diegopandolfa/ZEBRA/REDISEÑO/carrito_ZEBRA_digikey.pdf

carrito_ZEBRA_digikey
Index | Quantity | Part Number | Description
1 | 12493-1533-ND | | CAP ALUM 2200UF 20% 16V RADIAL
2 | 12493-1527-ND | | CAP ALUM 1000UF 20% 16V RADIAL
3 | 100 493-14722-1-ND | | CAP ALUM 100UF 20% 16V THRU HOLE
4 | 168 493-9414-1-ND | | CAP ALUM 220UF 20% 16V SMD
5 | 25493-9413-1-ND | | CAP ALUM 22UF 20% 16V SMD
6 | 12445-9911-1-ND | | CAP CER 1UF 16V X7R 0805
7 | 12493-9365-1-ND | | CAP ALUM 10UF 20% 16V SMD
8 | 25 A32562-ND | | CONN HEADER RTANG 8POS PCB TIN
9 | 25 A33904-ND | | CONN HEADER VERT 8POS PCB TIN
10 | 50 A28417-ND | | CONN RECPT 8POS .1" POL UNLOAD
11 | 100 1276-5298-1-ND | | RES SMD 3.3K OHM 1% 1/8W 0805
12 | 120 P1.0KDACT-ND | | RES SMD 1K OHM 0.1% 1/8W 0805
13 | 100 SS34FSCT-ND | | DIODE SCHOTTKY 40V 3A SMC
14 | 12296-37820-ND | | SENSOR TEMP ANLG VOLT TO-92-3
15 | 12497-2615-5-ND | | TRANS NPN 100V 3A TO-220
16 | 100 296-35399-1-ND | | IC REG BUCK ADJ 3A TO263-5
17 | 12160-1853-ND | | LED RED DIFF 5MM ROUND T/H
18 | 12 A9CCG-1603F-ND | | FLEX CABLE - AFG16G/AF16/AFG16G
19 | 24 A33890-ND | | CONN HEADER RTANG 16POS PCB TIN
20 | 25 A98248-ND | | TERM BLOCK HDR 2POS 90DEG 5MM
21 | 25 A98241-ND | | TERM BLOCK PLUG 2POS STR 5MM
22 | 36 A98249-ND | | TERM BLOCK HDR 3POS 90DEG 5MM
23 | 36 A113286-ND | | TERM BLOCK PLUG 3POS STR 5MM
24 | 132 P330CCT-ND | | RES SMD 330 OHM 1% 1/8W 0805
25 | 12497-1228-1-ND | | IC REG LINEAR 3.3V 1A SOT223
26 | 12 MMBT3904LT3GOSCT-ND | | TRANS NPN 40V 0.2A SOT23
27 | 108 TLP2745(TPECT-ND | | OPTOISO 5KV PUSH PULL SO6L
28 | 12768-1007-1-ND | | IC USB FS SERIAL UART 28-SSOP
29 | 100 CKN10684CT-ND | | SWITCH TACTILE SPST-NO 50MA 32V
30 | 300 1276-1096-1-ND | | CAP CER 10UF 16V X5R 0805
31 | 84 SRR1210-470MCT-ND | | FIXED IND 47UH 3.8A 72 MOHM SMD
32 | 121568-1464-ND | | TEENSY 3.5 (HEADERS)
33 | 12296-46127-1-ND | | ANALOG TEMPERATURE SENSOR
34 | 4 602-1558-ND | | RF TXRX MODULE 802.15.4 RP-SMA
35 | 4 553-1309-ND | | ANTENNA 2.4GHZ R-SMA BLACK 3"
36 | 276 1276-1099-1-ND | | CAP CER 0.1UF 25V X7R 0805
37 | 121582-1117-ND | | MEMORY CARD MICROSD 256MB SLC

Customer Reference | Available Quantity
CAP 2200 UF 16V | 12
CAP 1000UF 16V | 12
CAP 100UF 16V | 100
CAP 220UF 16V | 168
CAP 22UF 16V | 25
CAP 1UF 16V | 12
CAP 10UF 16V | 12
SOCKET HACIA PANELES (THRWHOLE RIGHT ANGLE) | 25
SOCKET PARA PANELES (THROWHOLE) | 25
CONECTORES PANELES | 50
RESISTENCIA PARA EL BUCK | 100
RESISTENCIA PARA EL BUCK | 120
DIODO PARA EL BUCK | 100
SENSOR DE TEMPERATURA | 12
PARA LA LUMINARIA | 12
LM2596 STEP DOWN BUCK | 100
LED INDIADOR DE LA PLACA DE POTENCIA | 12
CABLE FLEX DE AMBAS PLACAS | 0
CONECTOR PARA EL FLEX DE AMBAS PLACAS | 24
CONECTOR PCB PARA BRAZO Y ALIMENTACION | 25
CONECTOR CABLES BRAZO Y ALIMENTACION | 25
CONECTOR PCB PARA CINTAS | 36
CONECTOR CABLE DE CINTAS | 36
OPTO Y DEMASES | 132
REGULADOR 3V3 | 12
TRANSISTOR PARA RESET | 12
OPTOACOPLADORES | 108
FTDI PROGRAMACION INALAMBRICA | 12
SWITCH UZI | 100
CAPACITOR UZI | 300
INDUCTOR PARA EL BUCK | 84
Teensy con Headers | 12
LPM (patas dobladas) | 12
xBee con RP-SMA | 4
Antena RP-SMA | 4
0.1UF 25V | 276
MEMORIA SD 256MB | 12

Backorder Quantity | Unit Price USD | Extended Price USD
0 | 0.764 | 9.17
0 | 0.524 | 6.29
0 | 0.1072 | 10.72
0 | 0.2484 | 41.73
0 | 0.354 | 8.85
0 | 0.253 | 3.04
0 | 0.304 | 3.65
0 | 1.235 | 30.88
0 | 1.4 | 35.00
0 | 0.5514 | 27.57
0 | 0.0178 | 1.78
0 | 0.1182 | 14.18
0 | 0.4224 | 42.24
0 | 0.688 | 8.26
0 | 0.543 | 6.52
0 | 3.6153 | 361.53
0 | 0.24 | 2.88
12 | 6.636 | 79.63
0 | 2.416 | 57.98
0 | 0.4896 | 12.24
0 | 1.0892 | 27.23
0 | 0.548 | 19.73
0 | 1.3524 | 48.69
0 | 0.0305 | 4.03
0 | 0.603 | 7.24
0 | 0.102 | 1.22
0 | 0.7378 | 79.68
0 | 4.05 | 48.60
0 | 0.2825 | 28.25
0 | 0.0614 | 18.42
0 | 1.11 | 93.24
0 | 31.25 | 375.00
0 | 0.757 | 9.08
0 | 18.19 | 72.76
0 | 3.78 | 15.12
0 | 0.0125 | 3.45
0 | 9.966 | 119.59
TOTAL USD$ | | 1,735.47
