diegopandolfa/ZEBRA/esquematicos-zebra.pdf

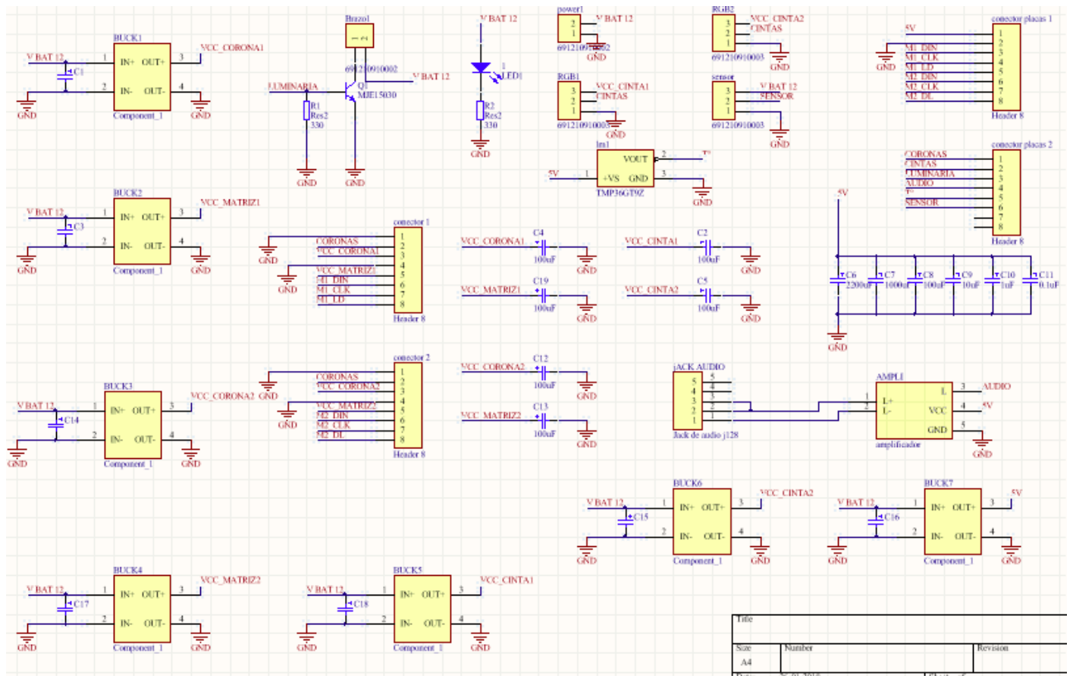
[picture p8: page 1]
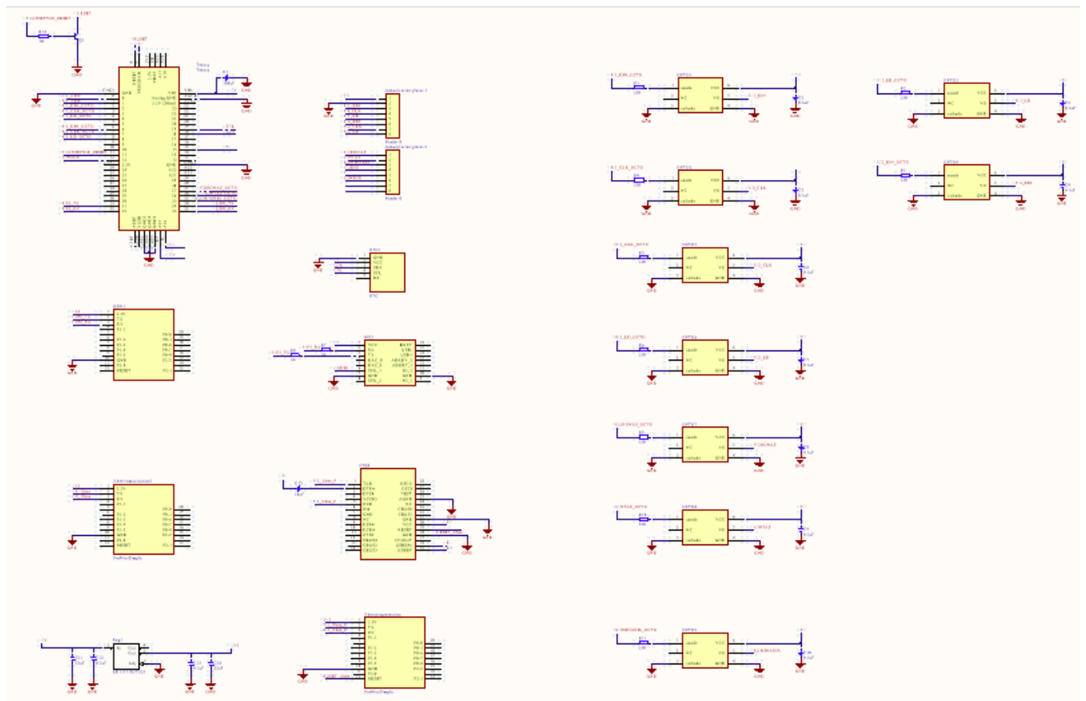
[picture p9: page 2]
