diegopandolfa/ZEBRA/lista de partes zebras.ods

Listado de Partes y Piezas Prototipo
index | Item | Code | Part Num | Proveedor | Cantidad | Precio unitario CLP | Unit Price USD | Total CLP | Total USD | Link
1 | PCB Potencia |  |  | Seeedstudio | 10
2 | PCB Control |  |  | Seeedstudio | 10
3 | Optoacoplador | TLP2745 | 757-TLP2745TPE (https://www.mouser.cl/ProductDetail/Toshiba/TLP2745TPE) | MOUSER | 100 | 0 | 0.542 | 0 | 54.2 | https://www.mouser.cl/ProductDetail/Toshiba/TLP2745TPE
4 | Modulo Buck LM2596 | LM2596 |  | MaxElectronica | 10 | 2990 | 0 | 29900 | 0 | http://www.maxelectronica.cl/prototipo/130-modulo-convertidor-dc-dc-fuente-de-poder-regulable-lm2596.html
5 | Teensy 3.5 | Teensy 3.5 | TEENSY35 | PJRC | 10 | 0 | 24.25 | 0 | 242.5 | https://www.pjrc.com/cgi-bin/store/step1?pn=TEENSY35&ref=%2Fstore%2F
6 | Pasta discipadora 3g | ID 26123 | ID 26123 | PCFactory | 2 | 4990 |  | 9980 | 0 | https://www.pcfactory.cl/producto/26123-pasta-termal-z5-3g
7 |  |  |  |  |  |  |  | 0 | 0
8 |  |  |  |  |  |  |  | 0 | 0
9 |  |  |  |  |  |  |  | 0 | 0
10 |  |  |  |  |  |  |  | 0 | 0
11 |  |  |  |  |  |  |  | 0 | 0
12 |  |  |  |  |  |  |  | 0 | 0
13 |  |  |  |  |  |  |  | 0 | 0
14 |  |  |  |  |  |  |  | 0 | 0
15 |  |  |  |  |  |  |  | 0 | 0
16 |  |  |  |  |  |  |  | 0 | 0
17 |  |  |  |  |  |  |  | 0 | 0
18 |  |  |  |  |  |  |  | 0 | 0
19 |  |  |  |  |  |  |  | 0 | 0
20 |  |  |  |  |  |  |  | 0 | 0
21 |  |  |  |  |  |  | Total | 39880 | 296.7
22
Listado de Partes y Piezas Final
index | Item | Code | Part Num | Proveedor | Cantidad | Precio unitario CLP | Unit Price USD | Total CLP | Total USD | Link
1 | PCB Potencia |  |  | Seeedstudio | 10
2 | PCB Control |  |  | Seeedstudio | 10
3 | Optoacoplador | TLP2745 | 757-TLP2745TPE (https://www.mouser.cl/ProductDetail/Toshiba/TLP2745TPE) | MOUSER | 100 | 0 | 0.542 | 0 | 54.2 | www.mouser.cl/ProductDetail/Toshiba/TLP2745TPE
4
5 | Teensy 3.5 | Teensy 3.5 | TEENSY35 | PJRC | 10 | 0 | 24.25 | 0 | 242.5 | www.pjrc.com/cgi-bin/store/step1?pn=TEENSY35&ref=%2Fstore%2F
6 | Pasta discipadora 3g | ID 26123 | ID 26123 | PCFactory | 2 | 4990 |  | 9980 | 0 | www.pcfactory.cl/producto/26123-pasta-termal-z5-3g
7 | Condensador 2200uF 16V |  | 493-1533-ND | Digikey |  |  |  | 0 | 0 | www.digikey.cl
8 | Condensador 1000uF 16V |  | 493-1527-ND | Digikey |  |  |  | 0 | 0 | www.digikey.cl
9 | Condensador 100uF 16V |  | 493-14722-1-ND | Digikey |  |  |  | 0 | 0 | www.digikey.cl
10 | Condensador 220uF 16V SMD |  | 493-9414-1-ND | Digikey |  |  |  | 0 | 0 | www.digikey.cl
11 | Condensador 22uF 16V SMD |  | 493-9413-1-ND | Digikey |  |  |  | 0 | 0 | www.digikey.cl
12 | Condensador 1uF 16V SMD |  | 445-13227-1-ND | Digikey |  |  |  | 0 | 0 | www.digikey.cl
13 | Condensador 0.1uF 16V SMD |  | 4445-5613-1-ND | Digikey |  |  |  | 0 | 0 | www.digikey.cl
14 | Resistencia |  |  |  |  |  |  | 0 | 0 | www.digikey.cl
15 | Conector 8 Pin Header Throwhole right angle |  | A32562-ND | Digikey |  |  |  | 0 | 0 | https://www.digikey.com/product-detail/en/te-connectivity-amp-connectors/5-103634-7/A32562-ND/1089962
16 | Flex 16 pin 3 pulgadas |  | A9CCG-1603F-ND | Digikey |  |  |  | 0 | 0 | https://www.digikey.com/product-detail/en/te-connectivity-amp-connectors/A9CCG-1603F/A9CCG-1603F-ND/470316
17 | Conector 16 pin thwohole right angle |  | A33890-ND | Digikey |  |  |  | 0 | 0 | https://www.digikey.com/product-detail/en/te-connectivity-amp-connectors/6-103634-5/A33890-ND/1122454
18 |  |  |  |  |  |  |  | 0 | 0
19 |  |  |  |  |  |  |  | 0 | 0
20 |  |  |  |  |  |  |  | 0 | 0
21 |  |  |  |  |  |  | Total | 9980 | 296.7
