diegopandolfa/ZEBRA/REDISEÑO/listado-de-componentes-carrito-de-compra-de-digikey.xlsx

Index | Quantity | Part Number | Manufacturer Part Number | Description | Customer Reference
1 | 15 | 493-1533-ND | UHE1C222MHD6 | CAP ALUM 2200UF 20% 16V RADIAL | CAP 2200 UF 16V
2 | 12 | 493-1527-ND | UHE1C102MHD6 | CAP ALUM 1000UF 20% 16V RADIAL | CAP 1000UF 16V
3 | 100 | 493-14722-1-ND | ULD1C101MED1TD | CAP ALUM 100UF 20% 16V THRU HOLE | CAP 100UF 16V
4 | 160 | 493-9414-1-ND | UCW1C221MCL1GS | CAP ALUM 220UF 20% 16V SMD | CAP 220UF 16V
5 | 25 | 493-9413-1-ND | UCW1C220MCL1GS | CAP ALUM 22UF 20% 16V SMD | CAP 22UF 16V
6 | 16 | 445-9911-1-ND | CGA4J2X7R1C105M125AD | CAP CER 1UF 16V X7R 0805 | CAP 1UF 16V
7 | 16 | 493-9365-1-ND | UCB1C100MCL1GS | CAP ALUM 10UF 20% 16V SMD | CAP 10UF 16V
8 | 25 | A32562-ND | 5-103634-7 | CONN HEADER RTANG 8POS PCB TIN | SOCKET HACIA PANELES (THRWHOLE RIGHT ANGLE)
9 | 25 | A33904-ND | 5-103669-7 | CONN HEADER VERT 8POS PCB TIN | SOCKET PARA PANELES (THROWHOLE)
10 | 50 | A28417-ND | 104257-7 | CONN RECPT 8POS .1" POL UNLOAD | CONECTORES PANELES
11 | 100 | 1276-5298-1-ND | RC2012F332CS | RES SMD 3.3K OHM 1% 1/8W 0805 | RESISTENCIA PARA EL BUCK
12 | 100 | SS34FSCT-ND | SS34 | DIODE SCHOTTKY 40V 3A SMC | DIODO PARA EL BUCK
13 | 100 | 296-35399-1-ND | LM2596SX-ADJ/NOPB | IC REG BUCK ADJ 3A TO263-5 | LM2596 STEP DOWN BUCK
14 | 25 | A33890-ND | 6-103634-5 | CONN HEADER RTANG 16POS PCB TIN | CONECTOR PARA EL FLEX DE AMBAS PLACAS
15 | 100 | A98248-ND | 796644-2 | TERM BLOCK HDR 2POS 90DEG 5MM | CONECTOR PCB PARA BRAZO Y ALIMENTACION
16 | 100 | A98241-ND | 796640-2 | TERM BLOCK PLUG 2POS STR 5MM | CONECTOR CABLES BRAZO Y ALIMENTACION
17 | 50 | A98249-ND | 796644-3 | TERM BLOCK HDR 3POS 90DEG 5MM | CONECTOR PCB PARA CINTAS
18 | 50 | 282805-3-SI-ND | 282805-3 | TERM BLOCK PLUG 3POS STR 5MM | CONECTOR CABLE DE CINTAS
19 | 200 | P330CCT-ND | ERJ-6ENF3300V | RES SMD 330 OHM 1% 1/8W 0805 | OPTO Y DEMASES
20 | 15 | 497-1228-1-ND | LD1117AS33TR | IC REG LINEAR 3.3V 1A SOT223 | REGULADOR 3V3
21 | 150 | TLP2745(TPECT-ND | TLP2745(TP,E | OPTOISO 5KV PUSH PULL SO6L | OPTOACOPLADORES
22 | 15 | 768-1007-1-ND | FT232RL-REEL | IC USB FS SERIAL UART 28-SSOP | FTDI PROGRAMACION INALAMBRICA
23 | 200 | CKN10684CT-ND | KMR621NG LFS | SWITCH TACTILE SPST-NO 50MA 32V | SWITCH UZI
24 | 300 | 1276-1096-1-ND | CL21A106KOQNNNE | CAP CER 10UF 16V X5R 0805 | CAPACITOR UZI
25 | 100 | SRR1210-470MCT-ND | SRR1210-470M | FIXED IND 47UH 3.8A 72 MOHM SMD | INDUCTOR PARA EL BUCK
26 | 12 | 1568-1464-ND | DEV-14056 | TEENSY 3.5 (HEADERS) | TEENSY CON HEADERS
27 | 15 | 296-46127-1-ND | LMT86LPM | ANALOG TEMPERATURE SENSOR | LPM (PATAS DOBLADAS)
28 | 500 | 1276-1099-1-ND | CL21B104KACNNNC | CAP CER 0.1UF 25V X7R 0805 | 0.1UF 25V
29 | 150 | 1276-5272-1-ND | RC2012F102CS | RES SMD 1K OHM 1% 1/8W 0805 | RESISTENCIA PARA EL BUCK
30 | 15 | SMMBT3904LT1GOSCT-ND | SMMBT3904LT1G | TRANS NPN 40V 0.2A SOT23 | TRANSISTOR PARA EL RESET
31 | 100 | P51ADCT-ND | ERJ-P06J510V | RES SMD 51 OHM 5% 1/2W 0805 | RESISTENCIA PARA EL TIP31C
32 | 5 | MCP73832T-2ACI/OTCT-ND | MCP73832T-2ACI/OT | IC LI-ION/LI-POLY CTRLR SOT23-5 | BATTERY CHARGER
33 | 5 | AE10921-ND | A-DF 09 A/KG-T2S | CONN D-SUB RCPT 9POS R/A SOLDER | DB9
34 | 4 | AZ75232GTR-G1DICT-ND | AZ75232GTR-G1 | IC BUS/BUFF TSSOP20 | RS232
35 | 4 | 296-26659-1-ND | SN75HVD3082EDR | IC TXRX RS485 1/1 HALF 8SOIC | RS485
36 | 4 | CDSOT23-SM712CT-ND | CDSOT23-SM712 | TVS DIODE 7VWM/12VWM SOT23 | TVS
37 | 10 | 541-10TACT-ND | CRCW080510R0JNEAHP | RES SMD 10 OHM 5% 1/2W 0805 | 10R 1/2 W
38 | 100 | 541-10KACT-ND | CRCW080510K0JNEA | RES SMD 10K OHM 5% 1/8W 0805 | 10K
39 | 10 | WM8195-ND | 90136-2104 | CONN HEADER 4POS .100" R/A TIN | CONECTOR PCB EXTENSIONES
40 | 4 | GS1M-LTPMSCT-ND | GS1M-LTP | DIODE GEN PURP 1KV 1A DO214AC | DIODO SELECTOR
41 | 12 | SI2302CDS-T1-E3CT-ND | SI2302CDS-T1-E3 | MOSFET N-CH 20V 2.6A SOT-23 | CONVERSOR DE NIVEL LOGICO
42 | 3 | 296-16010-1-ND | UC2577TDKTTT-ADJ | IC REG MULTI CONFIG ADJ 3A TO263 | BOOST
43 | 10 | 1276-7000-1-ND | CL21B104KBC5PNL | MLCC AUTOMOTIVE 2012(0805) X7R | 0.1UF 50V
44 | 12 | 1276-5287-1-ND | RC2012F202CS | RES SMD 2K OHM 1% 1/8W 0805 | 2K
45 | 10 | 1276-5302-1-ND | RC2012F392CS | RES SMD 3.9K OHM 1% 1/8W 0805 | 3K9
46 | 10 | 541-2836-1-ND | RCS0805470RFKEA | RES SMD 470 OHM 1% 0.4W 0805 | 470R 0.4W
47 | 10 | 445-8239-1-ND | C2012X5R1A476M125AC | CAP CER 47UF 10V X5R 0805 | 47UF 10V
48 | 4 | A100034-ND | 440054-2 | CONN HEADER 2POS 2MM VERT T/H | JST
49 | 25 | MJD31CT4GOSCT-ND | MJD31CT4G | TRANS NPN 100V 3A DPAK | BJT
50 | 2 | 602-1558-ND | XB24CZ7SIT-004 | RF TXRX MODULE 802.15.4 RP-SMA | XBEE PRO
51 | 25 | 475-1415-1-ND | LH R974-LP-1 | LED RED DIFFUSED 0805 SMD | LED SMD
52 | 25 | WM2902-ND | 50579404 | CONN HOUSING 4POS .100 W/LATCH | CONECTORES EXTERNOS
53 | 4 | A33897-ND | 5-103669-3 | CONN HEADER VERT 4POS PCB TIN | DISPLAY
