diegopandolfa/ZEBRA/Codigo Clean Voltage/Codigo Clean Voltage/Zebra Clean Voltage/Codigo Rediseño/Zebra_Teensy_Esclavo/Zebra_Teensy_Esclavo.ino

include <Adafruit_NeoPixel.h>
#include <Metro.h>
#include <Wire.h>
#include <RTClib.h>
#include <SoftwareSerial.h>  
#include <Sprite.h>  
#include <Matrix.h>
#include <EEPROM.h>
#include <DFPlayer_Mini_Mp3.h> 
#include <Sensor.h>
#include <LEDFader.h>
#define LED_PIN 3 // Pin de iluminacion
#define FADE_TIME 4000
LEDFader led;
SoftwareSerial mp3(11, 12);
Adafruit_NeoPixel cinta = Adafruit_NeoPixel(60, 6, NEO_GRB + NEO_KHZ800);
Adafruit_NeoPixel corona = Adafruit_NeoPixel(64, 10, NEO_GRB + NEO_KHZ800);
RTC_DS1307 RTC;

//---------------------TIMERS-------------------------------
Metro cintaTime = Metro(22);
Metro peatonTime = Metro(15000);
Metro sensado = Metro(10);
Metro coroOff = Metro(650);
Metro coroOn = Metro(1650);
Metro parpadeoTime = Metro(300);
Metro animationTime = Metro(100);
Metro newcalib = Metro(2000);
//---------------------------------------------------------
int direccion = 0;
int j = 59;
// ---- MATRICES-------------------------
Matrix matriz_1 = Matrix(3,4,5, 6);
Matrix matriz_2 = Matrix(7,8,9, 6);

uint16_t currentFrame = 0;
uint16_t currentFrame_SEC = 0;
uint16_t coroLimit = 0;
//----------------------------------------
int horaDia;
int horaNoche;
int minutoDia;
int minutoNoche;
//----------------SENSORES---------------
Sensor sensor1(0);
Sensor sensor2(1);
Sensor sensor3(2);
Sensor sensor4(3);
//-----------------------------------------
bool isPeatonPresent = false;
bool isNight = false;
uint16_t jumpStart = 1;
uint16_t currentPixel = 0;
uint32_t currentColor;
uint32_t coronaColor;
int calibrationFlag = 2;
int startFlag = 0;
bool estadoParpa = false;
bool activateAnimation = false;

//------------------ANIMACIONES----------------------------------------------
Sprite D0M1 = Sprite(8, 8,   
B00000000,
B00000000,
B00000000,
B00000001,
B00000011,
B00000111,
B00001111,
B01101111



);

Sprite D0M2 = Sprite(8, 8,   
B11111111,
B11111111,
B11110111,
B01100000,
B00000000,
B00000000,
B00000000,
B00000000



);
Sprite D0M3 = Sprite(8, 8,   
B00000000,
B00110000,
B11110000,
B11000000,
B10000000,
B10000000,
B11111111,
B11111111

);

Sprite D0M4 = Sprite(8, 8,   
B11111100,
B11111111,
B11100011,
B00110000,
B00011000,
B00011000,
B00000000,
B00000000


);
Sprite D0M5 = Sprite(8, 8,   
B00000000,
B00000000,
B00000011,
B00001111,
B00111111,
B01110011,
B11100000,
B11000000

);

Sprite D0M6 = Sprite(8, 8,   
B00000000,
B00000000,
B10000000,
B11100000,
B11111111,
B00111111,
B00000011,
B00000011

);


Sprite D1M1 = Sprite(8, 8, 
B00000000,
B00000000,
B00000000,
B00000000,
B00000001,
B00000011,
B00000111,
B01101111

);
Sprite D1M2 = Sprite(8, 8, 
B11111111,
B11111111,
B11110000,
B01100000,
B00000000,
B00000000,
B00000000,
B00000000


);
Sprite D1M3 = Sprite(8, 8, 
B00000000,
B00000000,
B00011100,
B00111100,
B11110000,
B11111110,
B11111111,
B11111111

);

Sprite D1M4 = Sprite(8, 8, 
B11111111,
B11110111,
B00110000,
B00011000,
B00011000,
B00000000,
B00000000,
B00000000

);
Sprite D1M5 = Sprite(8, 8, 
B00000000,
B00000000,
B00001110,
B00011111,
B00011011,
B00011000,
B11111000,
B11110000


);
Sprite D1M6 = Sprite(8, 8, 
B11000000,
B11110000,
B01111110,
B00001111,
B00000011,
B00000011,
B00000000,
B00000000

);

Sprite D2M1 = Sprite(8, 8, 
B00000000,
B00000000,
B00000000,
B00000000,
B00000000,
B00000011,
B01100111,
B11111111

);
Sprite D2M2 = Sprite(8, 8, 
B11111111,
B11110111,
B01100000,
B00000000,
B00000000,
B00000000,
B00000000,
B00000000

);

Sprite D2M3 = Sprite(8, 8, 
B00000000,
B00000000,
B00000000,
B00000000,
B00001100,
B11111100,
B11111111,
B11111111

);

Sprite D2M4 = Sprite(8, 8, 
B11111111,
B11111111,
B00011100,
B00001100,
B00000000,
B00000000,
B00000000,
B00000000

);
Sprite D2M5 = Sprite(8, 8, 
B00000000,
B00000000,
B00000000,
B00000000,
B00011110,
B00011110,
B00011000,
B11111000

);
Sprite D2M6 = Sprite(8, 8, 
B11111111,
B11111111,
B11000011,
B00000011,
B00000000,
B00000000,
B00000000,
B00000000

);


Sprite D3M1 = Sprite(8, 8, 
B00000000,
B00000000,
B00000000,
B00000000,
B00000000,
B00000011,
B01100111,
B11111111

);
Sprite D3M2 = Sprite(8, 8, 
B11111111,
B11110111,
B01100000,
B00000000,
B00000000,
B00000000,
B00000000,
B00000000

);
Sprite D3M3 = Sprite(8, 8, 
B00000000,
B00000000,
B00000000,
B00000000,
B00000000,
B11110000,
B11111110,
B11111111

);
Sprite D3M4 = Sprite(8, 8, 
B11111111,
B11111111,
B00011101,
B00000001,
B00000000,
B00000000,
B00000000,
B00000000

);
Sprite D3M5 = Sprite(8, 8, 
B00000000,
B00000000,
B00000000,
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
sensor4.MaxSave = sensor4.Max;
EEPROM.put(eeAddress, sensor1.MaxSave);
eeAddress += sizeof(int);
EEPROM.put(eeAddress, sensor2.MaxSave);
eeAddress += sizeof(int);
EEPROM.put(eeAddress, sensor3.MaxSave);
eeAddress += sizeof(int);
EEPROM.put(eeAddress, sensor4.MaxSave);
}

int getData(){
int eeAddress = 0; 
EEPROM.get(eeAddress, sensor1.MinSave);  
sensor1.Min = sensor1.MinSave;
eeAddress += sizeof(int);
EEPROM.get(eeAddress, sensor2.MinSave);  
sensor2.Min = sensor2.MinSave;
eeAddress += sizeof(int);
EEPROM.get(eeAddress, sensor3.MinSave);  
sensor3.Min = sensor3.MinSave;
eeAddress += sizeof(int);
EEPROM.get(eeAddress, sensor4.MinSave);  
sensor4.Min = sensor4.MinSave;
eeAddress += sizeof(int);
EEPROM.get(eeAddress, sensor1.MaxSave);
sensor1.Max = sensor1.MaxSave;
eeAddress += sizeof(int);
EEPROM.get(eeAddress, sensor2.MaxSave);
sensor2.Max = sensor2.MaxSave;
eeAddress += sizeof(int);
EEPROM.get(eeAddress, sensor3.MaxSave);
sensor3.Max = sensor3.MaxSave;
eeAddress += sizeof(int);
EEPROM.get(eeAddress, sensor4.MaxSave);
sensor4.Max = sensor4.MaxSave;
eeAddress += sizeof(int);
if(sensor1.MinSave > 0 && sensor2.MinSave > 0 && sensor3.MinSave > 0 && sensor4.MinSave > 0){
  calibrationFlag = 0;
  return 1;
} else {
  return 0;
}
}

void calibracionSetup(){ 
    sensor1.Min = 1023;        
    sensor1.Max = 0;
    sensor2.Min = 1023;
    sensor2.Max = 0;    
    sensor3.Min = 1023;
    sensor3.Max = 0;
    sensor4.Min = 1023;
    sensor4.Max = 0; 
    while (millis() < 10000) {
    sensor1.Value = sensor1.Average();
    sensor2.Value = sensor2.Average();
    sensor3.Value = sensor3.Average();
    sensor4.Value = sensor4.Average();
    
    if (sensor1.Value > sensor1.Max) {
      sensor1.Max = sensor1.Value;
    }

    if (sensor1.Value < sensor1.Min) {
      sensor1.Min = sensor1.Value;
    }

        if (sensor2.Value > sensor2.Max) {
      sensor2.Max = sensor2.Value;
    }

    if (sensor2.Value < sensor2.Min) {
      sensor2.Min = sensor2.Value;
    }


    if (sensor3.Value > sensor3.Max) {
      sensor3.Max = sensor3.Value;
    }

    if (sensor3.Value < sensor3.Min) {
      sensor3.Min = sensor3.Value;
    }


    if (sensor4.Value > sensor4.Max) {
      sensor4.Max = sensor4.Value;
    }

    if (sensor4.Value < sensor4.Min) {
      sensor4.Min = sensor4.Value;
    } 
  }
if((sensor1.Max - sensor1.Min) < 260 && (sensor2.Max - sensor2.Min) < 260 && (sensor3.Max - sensor3.Min) < 260 && (sensor4.Max - sensor4.Min) < 260){
sensor1.Min = sensor1.Min - 50;
sensor1.Max = sensor1.Max + 60;
sensor2.Min = sensor2.Min - 50;
sensor2.Max = sensor2.Max + 60;
sensor3.Min = sensor3.Min - 50;
sensor3.Max = sensor3.Max + 60;
sensor4.Min = sensor4.Min - 50;
sensor4.Max = sensor4.Max + 60;
//saveData();
//startFlag = 1;
} else {
  //digitalWrite(transistorPin, HIGH); 
}
}

void setup(){
  Serial.begin(115200); 
  Wire.begin();             
  RTC.begin();
  cinta.begin();
  cinta.show();
  corona.begin();
  corona.show();
  mp3.begin(9600);
  mp3_set_serial (mp3);   
  delay(1);                     
  mp3_set_volume (30); 
  matriz_1.clear();
  matriz_1.setBrightness(8); 
  matriz_2.clear();
  matriz_2.setBrightness(8); 
  currentColor = cinta.Color(255,48,0);
  coronaColor = corona.Color(255,48,0);
  led = LEDFader(LED_PIN);
  DateTime now = RTC.now(); 
  uint8_t hora = now.hour();
  uint8_t minuto = now.minute();
  uint8_t segundo = now.second();
  uint8_t Dia = now.day();
  uint8_t mes = now.month();
  if(hora > 5 && hora < 20){
  isNight = false;
  cinta.setBrightness(255);
  corona.setBrightness(255);
  currentColor = cinta.Color(255,48,0);
  coronaColor = corona.Color(255,48,0);
 } else {
  isNight = true;
  cinta.setBrightness(78);
  corona.setBrightness(78);
  currentColor = cinta.Color(255,48,0);
  coronaColor = corona.Color(255,48,0);
 }
   if(getData() == 1){
   } else {
   calibracionSetup();
   } 
}

void calibracionTest(){
    sensor1.Min = 1023;        
    sensor1.Max = 0;
    sensor2.Min = 1023;
    sensor2.Max = 0;    
    sensor3.Min = 1023;
    sensor3.Max = 0;
    sensor4.Min = 1023;
    sensor4.Max = 0; 
    calibrationFlag = 2;
    sensor1.Value = sensor1.Average();
    sensor2.Value = sensor2.Average();
    sensor3.Value = sensor3.Average();
    sensor4.Value = sensor4.Average();
    while(newcalib.check() != 1){
    sensor1.Value = sensor1.Average();
    sensor2.Value = sensor2.Average();
    sensor3.Value = sensor3.Average();
    sensor4.Value = sensor4.Average();
    
     if((sensor1.Value < sensor1.MinSec || sensor1.Value > sensor1.MaxSec || sensor2.Value < sensor2.MinSec ||  sensor2.Value > sensor2.MaxSec || sensor3.Value < sensor3.MinSec ||  sensor3.Value > sensor3.MaxSec || sensor4.Value < sensor4.MinSec ||  sensor4.Value > sensor4.MaxSec) && calibrationFlag == 2){
   if(sensor1.Value < 800 || sensor2.Value < 800 || sensor3.Value < 800 || sensor4.Value < 800){
        peaton(); 
    } 
  }  
    if (Serial.available() > 0) {
 int inByte = Serial.read();
 switch (inByte) {
        case 'P':
        if(isNight == true){
       // panel1.print('P');
       // panel2.print('P'); 
        }
        peatonTime.reset();
        isPeatonPresent = true;
        break;
}
  }
     if (sensor1.Value > sensor1.Max) {
      sensor1.Max = sensor1.Value;
    }

    if (sensor1.Value < sensor1.Min) {
      sensor1.Min = sensor1.Value;
    }

        if (sensor2.Value > sensor2.Max) {
      sensor2.Max = sensor2.Value;
    }

    if (sensor2.Value < sensor2.Min) {
      sensor2.Min = sensor2.Value;
    }


    if (sensor3.Value > sensor3.Max) {
      sensor3.Max = sensor3.Value;
    }

    if (sensor3.Value < sensor3.Min) {
      sensor3.Min = sensor3.Value;
    }


    if (sensor4.Value > sensor4.Max) {
      sensor4.Max = sensor4.Value;
    }

    if (sensor4.Value < sensor4.Min) {
      sensor4.Min = sensor4.Value;
    } 
  }
  
if((sensor1.Max - sensor1.Min) < 260 && (sensor2.Max - sensor2.Min) < 260 && (sensor3.Max - sensor3.Min) < 260 && (sensor4.Max - sensor4.Min) < 260){
sensor1.Min = sensor1.Min - 50;
sensor1.Max = sensor1.Max + 60;
sensor2.Min = sensor2.Min - 50;
sensor2.Max = sensor2.Max + 60;
sensor3.Min = sensor3.Min - 50;
sensor3.Max = sensor3.Max + 60;
sensor4.Min = sensor4.Min - 50;
sensor4.Max = sensor4.Max + 60;
startFlag = 1;
//saveData();
calibrationFlag = 0;
} else {
 sensor1.Min = sensor1.MinSave;
 sensor1.Max = sensor1.MaxSave; 
 sensor2.Min = sensor2.MinSave;
 sensor2.Max = sensor2.MaxSave; 
 sensor3.Min = sensor3.MinSave;
 sensor3.Max = sensor3.MaxSave; 
 sensor4.Min = sensor4.MinSave;
 sensor4.Max = sensor4.MaxSave; 
 calibrationFlag = 0;
}
}

void peaton(){
if(isPeatonPresent == false){
peatonTime.reset();
mp3_play (random(1, 7)); 
isPeatonPresent = true;
if(isNight == true){
  Serial.print('N');
  activateAnimation = true; 
  led.fade(255, FADE_TIME);
}
if(isNight == false){
  Serial.print('P');
  activateAnimation = false; 
} 
}
}

void loop(){
  led.update();
  sensor1.Value = sensor1.Average();
  sensor2.Value = sensor2.Average();
  sensor3.Value = sensor3.Average();
  sensor4.Value = sensor4.Average();

    if(peatonTime.check() == 1){
    isPeatonPresent = false;  
    led.fade(0, 2000);
}
  if(sensor1.Average() < sensor1.Min || sensor1.Average() > sensor1.Max || sensor2.Average() < sensor2.Min || sensor2.Average() > sensor2.Max || sensor3.Average() < sensor3.Min || sensor3.Average() > sensor3.Max || sensor4.Average() < sensor4.Min || sensor2.Average() > sensor2.Max && calibrationFlag == 2){
   peaton();
  }
  if(cintaTime.check() == 1 && jumpStart == 1 && isPeatonPresent == false) {
  patronCinta();
 }
  if(sensado.check() == 1 && isPeatonPresent == true) {
  patronCintaSensado();
 }

   if(animationTime.check() == 1 && isPeatonPresent == true && activateAnimation == true){
  caminar();      
  }

  if(parpadeoTime.check() == 1 && isPeatonPresent == true) {
  parpadeo(); 
 }

  if (Serial.available() > 0) {
 int inByte = Serial.read();
 switch (inByte) {
  
        case 'P': 
        peatonTime.reset();
        isPeatonPresent = true;
        if(isNight == true){
        led.fade(255, FADE_TIME); 
        activateAnimation == true;
        }
        break;

        case 'N': 
        peatonTime.reset();
        isPeatonPresent = true;
        led.fade(255, FADE_TIME); 
        activateAnimation == true;
        break;
      
        case 'S':
       coronaOn(); 
       jumpStart = 1;
       stand();
       stand_SEC();
        break;

       case 'W':
       coronaOn();  
       jumpStart = 1;
       break;

      case 'C':
      coronaOff(); 
      matriz_1.clear();
      matriz_2.clear();
      break;

      case 'H':
      isNight = true;
      cinta.setBrightness(78);
      corona.setBrightness(78);
      currentColor = cinta.Color(255,48,0);
      coronaColor = corona.Color(255,48,0);
      break;

      case 'L':
      saveData();
      coronaOff();
      cintaOff();
    //  digitalWrite(transistorPin, HIGH);   // RESET
      break;

      case 'Z':
      cinta.setBrightness(255);
      corona.setBrightness(255);
      currentColor = cinta.Color(255,48,0);
      coronaColor = corona.Color(255,48,0);
      break;
        
    }
  }
 
 DateTime now = RTC.now(); 
 uint8_t hora = now.hour();
 uint8_t minuto = now.minute();
 uint8_t segundo = now.second();
 uint8_t Dia = now.day();
 uint8_t mes = now.month();

if(hora == 4 && minuto == 30 && segundo < 10){
  Schedule();
}
 if(hora == horaDia && minuto == minutoDia && segundo < 10){
  isNight = false;
  cinta.setBrightness(255);
  corona.setBrightness(255);
 }
  if(hora == horaNoche && minuto == minutoNoche && segundo < 10){
  isNight = true;
  cinta.setBrightness(78);
  corona.setBrightness(78);
 }
}
void patronCinta(){
if(direccion == 1){
cinta.setPixelColor(currentPixel,currentColor);
cinta.setPixelColor(currentPixel-1,currentColor);
cinta.setPixelColor(currentPixel-2,currentColor);
cinta.setPixelColor(currentPixel-3,currentColor);
cinta.setPixelColor(currentPixel-4,currentColor);
cinta.setPixelColor(j,currentColor);
cinta.setPixelColor(j+1,currentColor);
cinta.setPixelColor(j+2,currentColor);
cinta.setPixelColor(j+3,currentColor);
cinta.setPixelColor(j+4,currentColor);
 } else if (direccion == 0){
cinta.setPixelColor(currentPixel,currentColor);
cinta.setPixelColor(currentPixel+1,currentColor);
cinta.setPixelColor(currentPixel+2,currentColor);
cinta.setPixelColor(currentPixel+3,currentColor);
cinta.setPixelColor(currentPixel+4,currentColor);
cinta.setPixelColor(j,currentColor);
cinta.setPixelColor(j-1,currentColor);
cinta.setPixelColor(j-2,currentColor);
cinta.setPixelColor(j-3,currentColor);
cinta.setPixelColor(j-4,currentColor);
  }
  cinta.show();
  cinta.setPixelColor(currentPixel,0,0,0);
  cinta.setPixelColor(j,0,0,0);
  if(direccion == 1){
  currentPixel--; 
  j++;
  } else if (direccion == 0){
  currentPixel++;
  j--;
  }
  if(currentPixel == 30){
    direccion = 1;
}
 if(currentPixel == 0){
    direccion = 0;
    j = 59;
    jumpStart =  0;
    cintaOff();
}
}

void cintaOff(){
for(int i = 0; i <= 60; i++){
cinta.setPixelColor(i,0,0,0);
}
cinta.show();
}
void patronCintaSensado(){
if(direccion == 1){
cinta.setPixelColor(currentPixel,currentColor);
cinta.setPixelColor(currentPixel-1,currentColor);
cinta.setPixelColor(currentPixel-2,currentColor);
cinta.setPixelColor(currentPixel-3,currentColor);
cinta.setPixelColor(currentPixel-4,currentColor);
cinta.setPixelColor(j,currentColor);
cinta.setPixelColor(j+1,currentColor);
cinta.setPixelColor(j+2,currentColor);
cinta.setPixelColor(j+3,currentColor);
cinta.setPixelColor(j+4,currentColor);
} else if (direccion == 0){
cinta.setPixelColor(currentPixel,currentColor);
cinta.setPixelColor(currentPixel+1,currentColor);
cinta.setPixelColor(currentPixel+2,currentColor);
cinta.setPixelColor(currentPixel+3,currentColor);
cinta.setPixelColor(currentPixel+4,currentColor);
cinta.setPixelColor(j,currentColor);
cinta.setPixelColor(j-1,currentColor);
cinta.setPixelColor(j-2,currentColor);
cinta.setPixelColor(j-3,currentColor);
cinta.setPixelColor(j-4,currentColor);
  }
  cinta.show();
  cinta.setPixelColor(currentPixel,0,0,0);
  cinta.setPixelColor(j,0,0,0);
  if(direccion == 1){
  currentPixel--; 
  j++;
  } else if (direccion == 0){
  currentPixel++;
  j--;
  }
  if(currentPixel == 30){
    direccion = 1;
}
 if(currentPixel == 0){
    direccion = 0;
    j = 59;
    jumpStart =  0;
    cintaOff();
}
}

void Schedule(){
 DateTime now = RTC.now(); 
 uint8_t hora = now.hour();
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
corona.setPixelColor(57,0,0,0);
corona.setPixelColor(58,coronaColor);
corona.setPixelColor(59,0,0,0);
corona.setPixelColor(60,coronaColor);
corona.setPixelColor(61,0,0,0);
corona.setPixelColor(62,coronaColor);
corona.setPixelColor(63,0,0,0);
corona.setPixelColor(64,coronaColor);
corona.show();
}
