diegopandolfa/ZEBRA/REDISEÑO/Codigo_Prototipo_Teensy/Prototipo-MASTER-ZEBRA-02-04-2018-NOCHE-descuartizado/Prototipo-MASTER-ZEBRA-02-04-2018-NOCHE-descuartizado.ino

////////////////////////////////////////////////////////////////////
//  @company :  CleanVolage                                       //
//  @author : Diego Pandolfa                                      //
//  @date : January 10, 2018                                      //
//  @proyect  : Zebras                                            //
//  @description  : Firmware desarrollado para el uC que controla //
//                  tanto el panel e1 como el mp3                 //
////////////////////////////////////////////////////////////////////
#include<FastLED.h>
#include<Metro.h>

#include <Sprite.h>  
#include <Matrix.h>

#include <Wire.h>
#include <RTClib.h>

#include <DFPlayer_Mini_Mp3.h> 

#define TIME_STAND_BY_RUTINE 2000
#define TIME_DETECTED_RUTINE 700
#define TIME_PEATON 15000 // 15 segundos

///////////// ----- Macros Cintas ------------///////////////
#define PIN_CINTAS 36
#define NUM_PIX_CINTAS 60
#define FRAME_TIME_CINTAS_STAND_BY 10
#define FRAME_TIME_CINTAS_DETECTED 10
#define FADE_TIME_CINTAS 50
#define HUE_CINTAS 10
///////////////--------Fin Cintas ---------//////////////////

///////////// ----- Macros Coronass ------------///////////////
#define PIN_CORONAS 37
#define NUM_PIX_CORONAS 64
#define FRAME_TIME_CORONAS_STAND_BY 300
#define FRAME_TIME_CORONAS_DETECTED 250
#define HUE_CORONAS 10
bool patron_coronas = false;
bool flag_cintas_fin = false;
///////////////--------Fin Coronas ---------//////////////////

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
B00000001,
B00000011,
B00000111,
B00001111,
B01101111
);

Sprite MSF5M2 = Sprite(8, 8,
B11111111,
B11111111,
B11110111,
B01100000,
B00000000,
B00000000,
B00000000,
B00000000
);

Sprite MSF5M3 = Sprite(8, 8,
B00000000,
B00000000,
B01111000,
B11111000,
B10000000,
B11111110,
B11111111,
B11111111
);

Sprite MSF5M4 = Sprite(8, 8,
B11111111,
B11111111,
B11100001,
B01111000,
B00011100,
B00001000,
B00000000,
B00000000
);

Sprite MSF5M5 = Sprite(8, 8,
B00000000,
B00000000,
B00000011,
B00000111,
B00001111,
B00011011,
B11111000,
B11110000
);

Sprite MSF5M6 = Sprite(8, 8,
B10000000,
B10000000,
B11000000,
B11111100,
B01111110,
B00000110,
B00000110,
B00000000
);

Sprite MSF6M1 = Sprite(8, 8,
B00000000,
B00000000,
B00000000,
B00000001,
B00000011,
B00000111,
B00001111,
B01101111
);

Sprite MSF6M2 = Sprite(8, 8,
B11111111,
B11111111,
B11110111,
B01100000,
B00000000,
B00000000,
B00000000,
B00000000
);

Sprite MSF6M3 = Sprite(8, 8,
B00000000,
B00111000,
B11111000,
B11000000,
B10000000,
B11111111,
B11111111,
B11111111
);

Sprite MSF6M4 = Sprite(8, 8,
B11111111,
B11111111,
B11100001,
B01110000,
B00111000,
B00011000,
B00000000,
B00000000
);

Sprite MSF6M5 = Sprite(8, 8,
B00000000,
B00000000,
B00000011,
B00000111,
B00011111,
B00111011,
B11110000,
B11100000
);

Sprite MSF6M6 = Sprite(8, 8,
B00000000,
B10000000,
B11000000,
B11111111,
B01111111,
B00000011,
B00000011,
B00000000
);

#define MP_DIN 2
#define MP_CLK 3
#define MP_LD 4
#define MS_DIN 6
#define MS_CLK 7
#define MS_LD 8
#define NUM_CHIPS_MAX 6
#define FRAME_TIME_MATRIX 100

Matrix matrix_principal = Matrix(MP_DIN, MP_CLK, MP_LD, NUM_CHIPS_MAX);

Matrix matrix_secundaria = Matrix(MS_DIN, MS_CLK, MS_LD, NUM_CHIPS_MAX);

Metro TimeOfFrameMatrix = Metro(FRAME_TIME_MATRIX);
int currentFrameMatrixPrincipal = 0;
/////////////----Fin Matriz Principal -------------////////////

// ---------------- Cintas y Coronas --------------//
CRGBArray<NUM_PIX_CINTAS> cintas;
CRGBArray<NUM_PIX_CORONAS> coronas;

Metro TimeStandByRutine = Metro(TIME_STAND_BY_RUTINE);

Metro TimeOfFrameCintas = Metro(FRAME_TIME_CINTAS_STAND_BY);

Metro TimeOfFrameCoronas = Metro(FRAME_TIME_CORONAS_STAND_BY);

int currentFrameCintas = 0;
//---------------Fin Cintas y Coronas ---------------//

Metro TimeOfPeaton = Metro(TIME_PEATON);

bool time_rutine_stand_by = true;
volatile bool peatonIsPresent = false;
int frameLightning = 0;

int resetPin = 11; // base de un transistor.
int interrupt_pin_sensor = 12;
int pinLightning = 35;
bool p = false;

bool isNight = true;
RTC_DS1307 RTC;
DateTime currentTime; 
uint8_t hora = 0;
uint8_t minuto = 0;
uint8_t segundo = 0;
uint8_t Dia = 0;
uint8_t mes = 0;
uint8_t anno = 0;

void setup() {
  pinMode(11, OUTPUT);
  digitalWrite(11, LOW);
  FastLED.addLeds<NEOPIXEL,PIN_CINTAS>(cintas, NUM_PIX_CINTAS);
  FastLED.addLeds<NEOPIXEL,PIN_CORONAS>(coronas, NUM_PIX_CORONAS);
  matrix_principal.clear();
  matrix_principal.setBrightness(8);
  pinMode(resetPin, OUTPUT);
  pinMode(interrupt_pin_sensor, INPUT_PULLUP);/////////////////// <------------------sensor con interrupcion
  attachInterrupt(digitalPinToInterrupt(interrupt_pin_sensor), interruptServiceRoutine, FALLING); // cantos de bajada
  pinMode(pinLightning,OUTPUT);
  Serial4.begin(9600);
  while(!Serial4);
  mp3_set_serial(Serial4); 
  delay(100);               
  mp3_set_volume(30);
  //////////////////////////////////////
  Serial.begin(115200);
  //while(!Serial);             
  if(!RTC.begin()){
    Serial.println("RTC not found!");
  }
  if (! RTC.isrunning()) {                       
  Serial.println("RTC is NOT running!");
  /////////////////////////////////////7
  Serial1.begin(115200);
  while(!Serial1);
  Serial1.println("Hola!");
  }
  currentTime = RTC.now();
  hora = currentTime.hour();
  minuto = currentTime.minute();
  segundo = currentTime.second();
  Dia = currentTime.day();
  mes = currentTime.month();
  anno = currentTime.year();
  String tmp = "fecha:\t";
  tmp += anno;
  tmp += "-";
  tmp += mes;
  tmp += "-";
  tmp += Dia;
  tmp += "\t";
  tmp += hora;
  tmp += ":";
  tmp += minuto;
  tmp += ":";
  tmp += segundo;
  Serial.println(tmp);
}

//----------Rutina de interrupción para el sensor-------//
void interruptServiceRoutine(){
  Serial.println("interrumpido!"); // debug
  TimeOfPeaton.reset();
  if(peatonIsPresent == false){
    Serial1.print("P"); // peaton
    mp3_next();
    TimeOfFrameMatrix.reset();
    TimeStandByRutine.reset();
    TimeStandByRutine.interval(TIME_DETECTED_RUTINE);
    peatonIsPresent = true;
  }
  else{
    Serial1.print("O");  
  }  
}

void loop(){
  if(peatonIsPresent){
    Serial.println("Peaton!");
    if(TimeOfFrameMatrix.check() == 1){
      if(isNight == true){
        patternWalk();
      }
      else{
        matrix_principal.clear();  
      }
    }
    if(TimeStandByRutine.check() == 1){
      time_rutine_stand_by = true;
    }
    if(TimeOfFrameCintas.check() == 1){
      patternCintas();
      if(isNight == true){
        lightOn();
      }
    }
    if(TimeOfFrameCoronas.check() == 1){
      patternCoronasOff();
    }
    if(flag_cintas_fin){
      TimeOfFrameCoronas.reset();
      flag_cintas_fin = false;
      patternCoronasOn();
    }
    if(TimeOfPeaton.check() == 1){
      peatonIsPresent = false;
      TimeStandByRutine.reset();
      TimeStandByRutine.interval(TIME_STAND_BY_RUTINE);
    }
  }
  else{
    Serial.println("no hay Peaton!");
    if(TimeStandByRutine.check() == 1){
      time_rutine_stand_by = true;
      currentTime = RTC.now();
      hora = currentTime.hour();
      minuto = currentTime.minute();
      segundo = currentTime.second();
      Dia = currentTime.day();
      mes = currentTime.month();
      if(isNight == true){
        Serial1.print("N");
        Serial.println("N");
      }
      else{
        Serial1.print("D");
        Serial.println("D"); 
      }
    }
    if(TimeOfFrameCintas.check() == 1){
      patternCintas();
      lightOff();  
    }
    if(TimeOfFrameCoronas.check() == 1){
      Serial.println("C");
      Serial1.print("C"); // clear
      patternCoronasOff();
      matrix_principal.clear();
      matrix_secundaria.clear();
    }
    if(flag_cintas_fin){
      TimeOfFrameCoronas.reset();
      flag_cintas_fin = false;
      if(isNight == true){
        //Serial.println("N");
        //Serial1.print("N"); // noche
        patternStandBy();
      }
      else{
        //Serial.println("D");
        //Serial1.print("D"); // dia
        matrix_principal.clear();
        matrix_secundaria.clear();  
      }
      patternCoronasOn();
    }
  }
  //FastLED.show();

  //----------------Zona horaria----------------------// 
  if(mes == 1){
    Serial.println("enero");
  //---------------DIA------------------------------
    if(hora == 5 && minuto == 14 && segundo > 0){
      //isNight = false; 
    }
 //----------------NOCHE---------------------------
    if(hora == 20 && minuto == 55 && segundo > 0){
      //isNight = true;
    }
 //------------------------------------------------
  }

  else if(mes == 2){
    Serial.println("febrero");
  //---------------DIA------------------------------
    if(hora == 5 && minuto == 54 && segundo > 0){
      //isNight = false; 
    }
 //----------------NOCHE---------------------------
    if(hora == 20 && minuto == 32 && segundo > 0){
      //isNight = true;
    }
 //------------------------------------------------
  }

  else if(mes == 3){
    Serial.println("marzo");
  //---------------DIA------------------------------
    if(hora == 6 && minuto == 22 && segundo > 0){
      //isNight = false; 
    }
 //----------------NOCHE---------------------------
    if(hora == 19 && minuto == 57 && segundo > 0){
      //isNight = true;
    }
 //------------------------------------------------
  }

  else if(mes == 4){
    Serial.println("abril");
  //---------------DIA------------------------------
    if(hora == 6 && minuto == 45 && segundo > 0){
      //isNight = false; 
    }
 //----------------NOCHE---------------------------
    if(hora == 19 && minuto == 17 && segundo > 0){
      //isNight = true;
    }
 //------------------------------------------------
  }

  else if(mes == 5){
    Serial.println("mayo");
  //---------------DIA------------------------------
    if(hora == 7 && minuto == 4 && segundo > 0){
      //isNight = false; 
    }
 //----------------NOCHE---------------------------
    if(hora == 18 && minuto == 49 && segundo > 0){
      //isNight = true;
    }
 //------------------------------------------------
  }

  else if(mes == 6){
    Serial.println("junio");
  //---------------DIA------------------------------
    if(hora == 7 && minuto == 18 && segundo > 0){
      //isNight = false; 
    }
 //----------------NOCHE---------------------------
    if(hora == 18 && minuto == 43 && segundo > 0){
      //isNight = true;
    }
 //------------------------------------------------
  }

  else if(mes == 7){
    Serial.println("julio");
  //---------------DIA------------------------------
    if(hora == 7 && minuto == 16 && segundo > 0){
      //isNight = false; 
    }
 //----------------NOCHE---------------------------
    if(hora == 18 && minuto == 55 && segundo > 0){
      //isNight = true;
    }
 //------------------------------------------------
  }

  else if(mes == 8){
    Serial.println("agosto");
  //---------------DIA------------------------------
    if(hora == 6 && minuto == 54 && segundo > 0){
      //isNight = false; 
    }
 //----------------NOCHE---------------------------
    if(hora == 19 && minuto == 17 && segundo > 0){
      //isNight = true;
    }
 //------------------------------------------------
  }

  else if(mes == 9){
    Serial.println("septiembre");
  //---------------DIA------------------------------
    if(hora == 6 && minuto == 15 && segundo > 0){
      //isNight = false; 
    }
 //----------------NOCHE---------------------------
    if(hora == 19 && minuto == 37 && segundo > 0){
      //isNight = true;
    }
 //------------------------------------------------
  }

  else if(mes == 10){
    Serial.println("octubre");
  //---------------DIA------------------------------
    if(hora == 5 && minuto == 31 && segundo > 0){
      //isNight = false; 
    }
 //----------------NOCHE---------------------------
    if(hora == 19 && minuto == 58 && segundo > 0){
      //isNight = true;
    }
 //------------------------------------------------
  }

  else if(mes == 11){
    Serial.println("noviembre");
  //---------------DIA------------------------------
    if(hora == 4 && minuto == 54 && segundo > 0){
      //isNight = false; 
    }
 //----------------NOCHE---------------------------
    if(hora == 20 && minuto == 27 && segundo > 0){
      //isNight = true;
    }
 //------------------------------------------------
  }
  else if(mes == 12){
    Serial.println("diciembre");
  //---------------DIA------------------------------
    if(hora == 4 && minuto == 46 && segundo > 0){
      //isNight = false; 
    }
 //----------------NOCHE---------------------------
    if(hora == 20 && minuto == 51 && segundo > 0){
      //isNight = true;
    }
  }
  //-------------------Fin zona horaria------------------------//

  //------------------- comunicacion---------------------------//
  if(Serial1.available()>0){
    Serial.println("datito!");
    char data_incomming = Serial1.read();
    if(data_incomming == 'P'){
      TimeOfPeaton.reset();
      if(peatonIsPresent == false){
        TimeOfFrameMatrix.reset();
        TimeStandByRutine.reset();
        TimeStandByRutine.interval(TIME_DETECTED_RUTINE);
        peatonIsPresent = true;
      }  
    }
    else if(data_incomming == 'O'){
      TimeOfPeaton.reset();  
    }  
  }
  //Serial.println("estoy aqui!");
}

void patternCintas(){
  if(currentFrameCintas >= NUM_PIX_CINTAS){
    currentFrameCintas = 0;
    time_rutine_stand_by = false;
  }
  cintas.fadeToBlackBy(FADE_TIME_CINTAS);
  if(time_rutine_stand_by){
    if(currentFrameCintas < NUM_PIX_CINTAS/2){
      // let's set an led value
      cintas[currentFrameCintas] = CHSV(HUE_CINTAS,255,255);
    }
    else{
      // let's set an led value
      if(currentFrameCintas == NUM_PIX_CINTAS-2)
        flag_cintas_fin = true;
      cintas[NUM_PIX_CINTAS-1 - currentFrameCintas] = CHSV(HUE_CINTAS,255,255);
    }
    cintas(NUM_PIX_CINTAS/2,NUM_PIX_CINTAS-1) = cintas(NUM_PIX_CINTAS/2 - 1 ,0);
    currentFrameCintas++;
  }
  FastLED.show();
}

void patternCoronasOn(){
  for(int i=0; i<NUM_PIX_CORONAS; i++){
    if(patron_coronas == false){
      if( (i%2) == 0 ){
        coronas[i] = CHSV(HUE_CORONAS,255,255);  
      }
      else{
        coronas[i] = CHSV(HUE_CORONAS,255,0);
      }
    }
    else if(patron_coronas == true){
      if( ((i+1)%2) == 0){
        coronas[i] = CHSV(HUE_CORONAS,255,255); 
      }
      else{
        coronas[i] = CHSV(HUE_CORONAS,255,0);
      }
    }
  }
  patron_coronas = !(patron_coronas);
}

void patternCoronasOff(){
  for(int i=0; i<NUM_PIX_CORONAS; i++){
    coronas[i] = CHSV(HUE_CORONAS,255,0);
  }
}

void patternWalk(){
  if(currentFrameMatrixPrincipal == 0){
    matrix_principal.write(40, 0,  MPF0M1);
    matrix_principal.write(32, 0,  MPF0M2);
    matrix_principal.write(24, 0, MPF0M3);
    matrix_principal.write(16, 0, MPF0M4);
    matrix_principal.write(8, 0, MPF0M5);
    matrix_principal.write(0, 0, MPF0M6);
    matrix_secundaria.write(40, 0,  MSF0M1);
    matrix_secundaria.write(32, 0,  MSF0M2);
    matrix_secundaria.write(24, 0, MSF0M3);
    matrix_secundaria.write(16, 0, MSF0M4);
    matrix_secundaria.write(8, 0, MSF0M5);
    matrix_secundaria.write(0, 0, MSF0M6); 
  }
  if(currentFrameMatrixPrincipal == 1){
    matrix_principal.write(40, 0,  MPF1M1);
    matrix_principal.write(32, 0,  MPF1M2);
    matrix_principal.write(24, 0, MPF1M3);
    matrix_principal.write(16, 0, MPF1M4);
    matrix_principal.write(8, 0, MPF1M5);
    matrix_principal.write(0, 0, MPF1M6);
    matrix_secundaria.write(40, 0,  MSF1M1);
    matrix_secundaria.write(32, 0,  MSF1M2);
    matrix_secundaria.write(24, 0, MSF1M3);
    matrix_secundaria.write(16, 0, MSF1M4);
    matrix_secundaria.write(8, 0, MSF1M5);
    matrix_secundaria.write(0, 0, MSF1M6);
  }
  if(currentFrameMatrixPrincipal == 2){
    matrix_principal.write(40, 0,  MPF2M1);
    matrix_principal.write(32, 0,  MPF2M2);
    matrix_principal.write(24, 0, MPF2M3);
    matrix_principal.write(16, 0, MPF2M4);
    matrix_principal.write(8, 0, MPF2M5);
    matrix_principal.write(0, 0, MPF2M6);
    matrix_secundaria.write(40, 0,  MSF2M1);
    matrix_secundaria.write(32, 0,  MSF2M2);
    matrix_secundaria.write(24, 0, MSF2M3);
    matrix_secundaria.write(16, 0, MSF2M4);
    matrix_secundaria.write(8, 0, MSF2M5);
    matrix_secundaria.write(0, 0, MSF2M6);
  }
  if(currentFrameMatrixPrincipal == 3){
    matrix_principal.write(40, 0,  MPF3M1);
    matrix_principal.write(32, 0,  MPF3M2);
    matrix_principal.write(24, 0, MPF3M3);
    matrix_principal.write(16, 0, MPF3M4);
    matrix_principal.write(8, 0, MPF3M5);
    matrix_principal.write(0, 0, MPF3M6);
    matrix_secundaria.write(40, 0,  MSF3M1);
    matrix_secundaria.write(32, 0,  MSF3M2);
    matrix_secundaria.write(24, 0, MSF3M3);
    matrix_secundaria.write(16, 0, MSF3M4);
    matrix_secundaria.write(8, 0, MSF3M5);
    matrix_secundaria.write(0, 0, MSF3M6);
  }
  if(currentFrameMatrixPrincipal == 4){
    matrix_principal.write(40, 0,  MPF4M1);
    matrix_principal.write(32, 0,  MPF4M2);
    matrix_principal.write(24, 0, MPF4M3);
    matrix_principal.write(16, 0, MPF4M4);
    matrix_principal.write(8, 0, MPF4M5);
    matrix_principal.write(0, 0, MPF4M6);
    matrix_secundaria.write(40, 0,  MSF4M1);
    matrix_secundaria.write(32, 0,  MSF4M2);
    matrix_secundaria.write(24, 0, MSF4M3);
    matrix_secundaria.write(16, 0, MSF4M4);
    matrix_secundaria.write(8, 0, MSF4M5);
    matrix_secundaria.write(0, 0, MSF4M6);
  }
  if(currentFrameMatrixPrincipal == 5){
    matrix_principal.write(40, 0,  MPF5M1);
    matrix_principal.write(32, 0,  MPF5M2);
    matrix_principal.write(24, 0, MPF5M3);
    matrix_principal.write(16, 0, MPF5M4);
    matrix_principal.write(8, 0, MPF5M5);
    matrix_principal.write(0, 0, MPF5M6);
    matrix_secundaria.write(40, 0,  MSF5M1);
    matrix_secundaria.write(32, 0,  MSF5M2);
    matrix_secundaria.write(24, 0, MSF5M3);
    matrix_secundaria.write(16, 0, MSF5M4);
    matrix_secundaria.write(8, 0, MSF5M5);
    matrix_secundaria.write(0, 0, MSF5M6);
  }
  if(currentFrameMatrixPrincipal == 6){
    matrix_principal.write(40, 0,  MPF6M1);
    matrix_principal.write(32, 0,  MPF6M2);
    matrix_principal.write(24, 0, MPF6M3);
    matrix_principal.write(16, 0, MPF6M4);
    matrix_principal.write(8, 0, MPF6M5);
    matrix_principal.write(0, 0, MPF6M6);
    matrix_secundaria.write(40, 0,  MSF6M1);
    matrix_secundaria.write(32, 0,  MSF6M2);
    matrix_secundaria.write(24, 0, MSF6M3);
    matrix_secundaria.write(16, 0, MSF6M4);
    matrix_secundaria.write(8, 0, MSF6M5);
    matrix_secundaria.write(0, 0, MSF6M6);
  }
  currentFrameMatrixPrincipal++;
  if(currentFrameMatrixPrincipal > 6){
    currentFrameMatrixPrincipal = 0;
  }
}

void patternStandBy(){
  matrix_principal.write(40, 0,   FSM1);
  matrix_principal.write(32, 0,   FSM2);
  matrix_principal.write(24, 0,  FSM3);
  matrix_principal.write(16, 0,  FSM4);
  matrix_principal.write(8, 0,  FSM5);
  matrix_principal.write(0, 0,  FSM6);
  matrix_secundaria.write(40, 0,   FSM1);
  matrix_secundaria.write(32, 0,   FSM2);
  matrix_secundaria.write(24, 0,  FSM3);
  matrix_secundaria.write(16, 0,  FSM4);
  matrix_secundaria.write(8, 0,  FSM5);
  matrix_secundaria.write(0, 0,  FSM6);
}

void patternOK(){
  matrix_principal.write(24, 0,  M1);
  matrix_principal.write(16, 0,  M2);
}

void lightOn(){
//  if(frameLightning < 255){
//    analogWrite(pinLightning,frameLightning++);
//  }
//  else if(p == false){
    digitalWrite(pinLightning, HIGH);
//    p = true;
//  }
}

void lightOff(){
//  if(frameLightning > 0){
//    analogWrite(pinLightning,--frameLightning);
//  }
//  else if(p == true){
    digitalWrite(pinLightning, LOW);
//    p = false;
//  }
}
