diegopandolfa/ZEBRA/CleanVoltageSource/Matriz_Auxiliar_10-01-2018_depurado/Matriz_Auxiliar_10-01-2018_depurado.ino

////////////////////////////////////////////////////////////////////
//  @company :  CleanVolage                                       //
//  @author : Andres Lin                                          //
//                                                                //
//  @edited : Diego Pandolfa                                      //
//  @date : January 10, 2018                                      //
//  @proyect  : Zebras                                            //
//  @description  : Firmware desarrollado para el uC que controla //
//                  el panel 2                                    //
////////////////////////////////////////////////////////////////////
#include <Sprite.h>  
#include <Matrix.h>
#include <Metro.h>

const int numChips = 6;
uint16_t currentFrame = 0;
bool isPeatonPresent = false;

Matrix myLeds = Matrix(4,5,6, numChips);
Metro animationTime = Metro(100);
Metro peatonTime = Metro(15000);

Sprite M1 = Sprite(8, 8,   
B00000000,
B01111110,
B10000001,
B10000001,
B10000001,
B10000001,
B01111110,
B00000000
);

Sprite M2 = Sprite(8, 8,   
B00000000,
B00000000,
B01111111,
B00001000,
B00010100,
B00100010,
B01000001,
B00000000
);

Sprite F0M1 = Sprite(8, 8,   
B00000000,
B00000000,
B00000000,
B00000001,
B00000011,
B00000111,
B00001111,
B01101111
);

Sprite F0M2 = Sprite(8, 8,   
B11111111,
B11111111,
B11110111,
B01100000,
B00000000,
B00000000,
B00000000,
B00000000
);

Sprite F0M3 = Sprite(8, 8,   
B00000000,
B00110000,
B11110000,
B11000000,
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
    currentFrame = 0; 
  }
}

void stand(){
  myLeds.write(40, 0,   FSM1);
  myLeds.write(32, 0,   FSM2);
  myLeds.write(24, 0,  FSM3);
  myLeds.write(16, 0,  FSM4);
  myLeds.write(8, 0,  FSM5);
  myLeds.write(0, 0,  FSM6);
}

void ok(){
  myLeds.write(24, 0,  M1);
  myLeds.write(16, 0,  M2);
}
