diegopandolfa/ZEBRA/REDISEÑO/Programs/MASTER_16-01-18/MASTER_16-01-18.ino

////////////////////////////////////////////////////////////////////
//  @company :  CleanVolage                                       //
//  @author : Diego Pandolfa                                      //
//  @date : January 10, 2018                                      //
//  @proyect  : Zebras                                            //
//  @version  : 2.0                                               //
//  @description  : Firmware desarrollado para el zebra TX        //
//                  que envia los mensajes de sincronización      //
////////////////////////////////////////////////////////////////////
#include <Adafruit_NeoPixel.h>
#include <Metro.h>
#include <Wire.h>
#include <RTClib.h>


void setup() {
  // put your setup code here, to run once:

}

void loop() {
  // put your main code here, to run repeatedly:

}
